PACordonnier/Knocklet/docs/plugin/fr_FR/partie_3.asciidoc

===== PHP
Ce dossier contient la vue à proprement parler, dedans on retrouve obligatoire la page de configuration du plugin (celle qui apparaîtra quand l'utilisateur fera plugin => catégorie => votre plugin), il est conseillé de nommer celle-ci avec l'id de votre plugin. Il peut aussi contenir le panel (page que l'utilisateur trouvera dans accueil -> nom de votre plugin).

Tous les fichiers dans ce dossier doivent finir par .php et doit obligatoirement commencer par :

----
<?php
if (!isConnect('admin')) {
    throw new Exception('{{401 - Accès non autorisé}}');
 }
 sendVarToJS('eqType', 'mail');
 ?>
----
Une fois sur cette page vous aurez accès en php à toutes les fonctions du core de jeedom (voir http://dev.jeedom.fr) ainsi qu'à celles de tous les modules installés donc le vôtre aussi.

Toutes ces pages étant des vues elles utilisent principalement la syntaxe HTML. Pour tout ce qui est présentation, Jeedom se base principalement sur  bootstrap donc toute la documentation est applicable (http://getbootstrap.com/).

Pour simplifier la création de plugin vous pouvez inclure dans votre page le script javascript de template pour les plugins :

----
<?php include_file('core', 'plugin.template', 'js'); ?>
----
A mettre tout en bas de votre page et utile uniquement sur la page de configuration de votre plugin. Ce script permet de réduire le javascript obligatoire à une seule fonction (voir partie sur les fichiers JS).

Dans votre page de configuration une syntaxe html a été mise en place pour vous simplifier la vie. Donc pour la plupart des plugins vous n'aurez  à faire que du html pour stocker vos informations en base de données et donc vous en resservir du coté de votre classe.

Pour la syntaxe c'est assez simple votre élément (input, select...) doit avoir la classe css eqLogicAttr (ou cmdAttr pour les commandes) et un attribut indiquant le nom de la propriété :

----
<input type="text" class="eqLogicAttr form-control" data-l1key="name" placeholder="{{Nom de l'équipement mail}}"/>
----
Là par exemple lors du chargement des données jeedom mettra la valeur du nom de l'équipement dans l'input et lors de la sauvegarde récupérera celle-ci pour la remettre en BDD. Petite astuce certaines propriétés sont en fait des chaînes JSON en BDD (ça permet d'avoir vraiment pas mal de libertés pour le plugin), dans ce cas il suffit de faire :

----
<input class="eqLogicAttr form-control" data-l1key='configuration' data-l2key='fromName' />
----
Pour la liste des propriétés des équipements c'est ici et des commandes c'est ici (pour voir les propriétés qui sont de JSON il suffit de regarder le getter ou le setter si celui-ci prend 2 paramètres alors c'est du JSON)

Dernier point important sur la page de configuration celle-ci peut contenir autant d'équipements et de commandes que nécessaire. Cependant il y a quelques règles à respecter :

Tous les éléments ayant la classe eqLogicAttr doivent être dans un élément ayant la classe css eqLogic
Idem pour les éléments de classe css cmdAttr qui doivent être dans un élément de classe cmd.
Toutes les commandes d'un équipement doivent se trouver dans l'élément ayant la classe eqLogic correspondant

===== JS

Tous les fichiers JS doivent se trouver dans le dossier JS (facile !!!). Il est conseillé de le nommer du même ID que votre plugin (pour la partie configuration, pour le panel vous faîtes comme vous voulez). Ce fichier JS (celui de la configuration du plugin) doit au minimum contenir une méthode addCmdToTable qui prend en paramètre l'objet commande à ajouter. Voici un exemple simple :

----
function addCmdToTable(_cmd) {
    if (!isset(_cmd)) {
        var _cmd = {configuration: {}};
     }
 	var tr = '';     tr += '';
     tr += '<input class="cmdAttr form-control input-sm" data-l1key="id" style="display : none;">';
 	tr += '<input class="cmdAttr form-control input-sm" data-l1key="name">';     tr += '<input class="cmdAttr form-control input-sm" data-l1key="configuration" data-l2key="recipient">';     tr += '';
     tr += '<input class="cmdAttr form-control input-sm" data-l1key="type" value="action" style="display : none;">';
     tr += '<input class="cmdAttr form-control input-sm" data-l1key="subType" value="message" style="display : none;">';
     if (is_numeric(_cmd.id)) {
        tr += '<a class="btn btn-default btn-xs cmdAction" data-action="test"><i class="fa fa-rss"></i> {{Tester}}</a>';
     }
     tr += '<i class="fa fa-minus-circle pull-right cmdAction cursor" data-action="remove"></i></td>';
 	tr += '';
     $('#table_cmd tbody').append(tr);
    $('#table_cmd tbody tr:last').setValues(_cmd, '.cmdAttr');
}
----

Vous remarquerez qu'il y a une ligne par commande et que celle-ci a bien la classe css cmd. Vous pouvez aussi voir les éléments qui ont la classe cmdAttr.

Plusieurs points importants :

- cette fonction peut être appelée avec un objet vide (d'où les 3 premières lignes) lors de l'ajout d'une nouvelle commande
- la dernière ligne permet d'initialiser tous les champs une fois la ligne insérée

Dernier point un exemple plus complet avec type et sous-type de commande :

----
function addCmdToTable(_cmd) {
    if (!isset(_cmd)) {
        var _cmd = {};
    }
     if (!isset(_cmd.configuration)) {
        _cmd.configuration = {};
    }
     var selRequestType = '<select style="width : 90px;" class="cmdAttr form-control input-sm" data-l1key="configuration" data-l2key="requestType">';
     selRequestType += '<option value="script">{{Script}}</option>';
     selRequestType += '<option value="http">{{Http}}</option>';
     selRequestType += '</select>';
 	var tr = '';     tr += '<input class="cmdAttr form-control input-sm" data-l1key="name" style="width : 140px;">';     
 	tr += '<input class="cmdAttr form-control input-sm" data-l1key="id"  style="display : none;">';     
 	tr += '' + selRequestType;
    tr += '<div class="requestTypeConfig" data-type="http">';
     tr += '<input type="checkbox" class="cmdAttr" data-l1key="configuration" data-l2key="noSslCheck" />Ne pas vérifier SSL';
    tr += '</div>';  
 	tr += '';     tr += '';
     tr += '<span class="type" type="' + init(_cmd.type) + '">' + jeedom.cmd.availableType() + '</span>';
     tr += '<span class="subType" subType="' + init(_cmd.subType) + '"></span>';   
 	tr += '';     tr += '<textarea style="height : 95px;" class="cmdAttr form-control input-sm" data-l1key="configuration" data-l2key="request"></textarea>';
     tr += '<a class="btn btn-default browseScriptFile cursor input-sm" style="margin-top : 5px;"><i class="fa fa-folder-open"></i> {{Parcourir}}</a> ';
     tr += '<a class="btn btn-default editScriptFile cursor input-sm" style="margin-top : 5px;"><i class="fa fa-edit"></i> {{Editer}}</a> ';
     tr += '<a class="btn btn-success newScriptFile cursor input-sm" style="margin-top : 5px;"><i class="fa fa-file-o"></i> {{Nouveau}}</a> ';
     tr += '<a class="btn btn-danger removeScriptFile cursor input-sm" style="margin-top : 5px;"><i class="fa fa-trash-o"></i> {{Supprimer}}</a> ';
     tr += '<a class="btn btn-warning bt_shareOnMarket cursor input-sm" style="margin-top : 5px;"><i class="fa fa-cloud-upload"></i> {{Partager}}</a> ';
     tr += '</div>';   
 	tr += '';     tr += '';
     tr += '<input class="cmdAttr form-control tooltips input-sm" data-l1key="unite"  style="width : 100px;" placeholder="{{Unité}}" title="{{Unité}}">';
     tr += '<input class="tooltips cmdAttr form-control input-sm" data-l1key="configuration" data-l2key="minValue" placeholder="{{Min}}" title="{{Min}}"> ';
     tr += '<input class="tooltips cmdAttr form-control input-sm" data-l1key="configuration" data-l2key="maxValue" placeholder="{{Max}}" title="{{Max}}">';   
 	tr += '';     tr += '';
     tr += '<span><input type="checkbox" class="cmdAttr" data-l1key="isHistorized" /> {{Historiser}}<br/></span>';
 	tr += '';     tr += '';
     if (is_numeric(_cmd.id)) {
        tr += '<a class="btn btn-default btn-xs cmdAction" data-action="test"><i class="fa fa-rss"></i> {{Tester}}</a>';
     }
     tr += '<i class="fa fa-minus-circle pull-right cmdAction cursor" data-action="remove"></i></td>';
 	tr += '';
     $('#table_cmd tbody').append(tr);
    $('#table_cmd tbody tr:last').setValues(_cmd, '.cmdAttr');
	
    if (isset(_cmd.configuration.requestType)) {
        $('#table_cmd tbody tr:last .cmdAttr[data-l1key=configuration][data-l2key=requestType]').value(init(_cmd.configuration.requestType));
        $('#table_cmd tbody tr:last .cmdAttr[data-l1key=configuration][data-l2key=requestType]').trigger('change');
    }
 	
     if (isset(_cmd.type)) {
        $('#table_cmd tbody tr:last .cmdAttr[data-l1key=type]').value(init(_cmd.type));
    }
     jeedom.cmd.changeType($('#table_cmd tbody tr:last'), init(_cmd.subType));
    initTooltips();
}
----

Ici on peut remarquer :

- jeedom.cmd.availableType() qui va insérer un select avec la liste des types connus (action et info pour le moment)
- <span class="subType" subType="' + init(_cmd.subType) + '"></span>: l'endroit où le select de sous type doit être posé
- jeedom.cmd.changeType($('#table_cmd tbody tr:last'), init(_cmd.subType)) qui permet d'initialiser le sous type avec la bonne valeur

D'autres fonctions javascript peuvent être utilisées :

- printEqLogic qui prend en paramètre tout l'objet de l'équipement (utile en cas de traitement de données avant de les restituer). Elle est appelée lors de l'affichage des données de l'équipement
- saveEqLogic qui prend en paramètre l'objet équipement qui va être sauvegardé en base de données (utile si vous devez faire du traitement avant sauvegarde)
Dernière chose, pour les fichiers JS, voici comment les inclure de manière propre sur votre page php :

----
<?php include_file('desktop', 'weather', 'js', 'weather'); ?>
----
Le premier argument donne le dossier dans lequel le trouver (attention c'est le dossier père du dossier JS), le deuxième le nom de votre javascript, le troisième indique à Jeedom que c'est un fichier JS et le dernier dans quel plugin il se trouve.

===== CSS
Ce dossier contient vos fichiers CSS (il ne devrait pas être trop utilisé) , voici comment les inclure sur votre page :

----
<?php include_file('desktop', 'weather', 'css', 'weather'); ?>
----
Le premier argument donne le dossier dans lequel le trouver (attention c'est le dossier père du dossier CSS), le deuxième le nom de votre fichier css, le troisième indique à Jeedom que c'est un fichier CSS et le dernier dans quel plugin il se trouve.

===== MODAL
Le dossier modal vous permet de stocker vos fichiers php destinés à afficher des modals. Voici comment les appeler à partir de votre page principale (ce code se met dans un fichier javascript) :

On peut voir :

----
$('#md_modal').dialog({title: "{{Classe du périphérique}}"});
 $('#md_modal').load('index.php?v=d&plugin=zwave&modal=show.class&id=' + $('.eqLogicAttr[data-l1key=id]').value()).dialog('open');
----

La première permet de mettre un titre à votre modal

La deuxième ligne charge votre modal et l'affichage. Pour la syntaxe c'est assez simple : plugin l'id de votre plugin, modal le nom de votre modal sans le php et ensuite les paramètres que vous voulez lui passer

===== API JS
Ce n'est pas un dossier mais dans les dernières versions de Jeedom celui-ci offre au développeur toute une api javascript (ça évite d'écrire des appels ajax dans tous les sens). J'essayerai de faire un article pour expliquer les différentes fonctionnalités mais vous pouvez déjà trouver le code ici.

Voilà pour les détails du dossier desktop. Je me doute que c'est pas des plus complets (j'essayerai de le compléter en fonction des différentes demandes que je reçois) mais j’espère que grâce à ça vous pourrez commencer à faire des plugins pour Jeedom.

===== Trucs et astuces

.Assitant cron

----
$('body').delegate('.helpSelectCron','click',function(){
  var el = $(this).closest('.schedule').find('.scenarioAttr[data-l1key=schedule]');
  jeedom.getCronSelectModal({},function (result) {
    el.value(result.value);
  });
});
----

Quand on clique sur le bouton d'assistant, ça récupère l'input dans lequel écrire puis appelle l'assistant. Une fois la configuration finie dans l’assistant, le résultat est récuperé puis écrit dans l'input précédemment selectionné
