PACordonnier/Knocklet/pitch/Knocklet.pptx

## Knocklet

Pitch du 23 Septembre 2016
PFE1619 Dome – Valorisation Partenariat

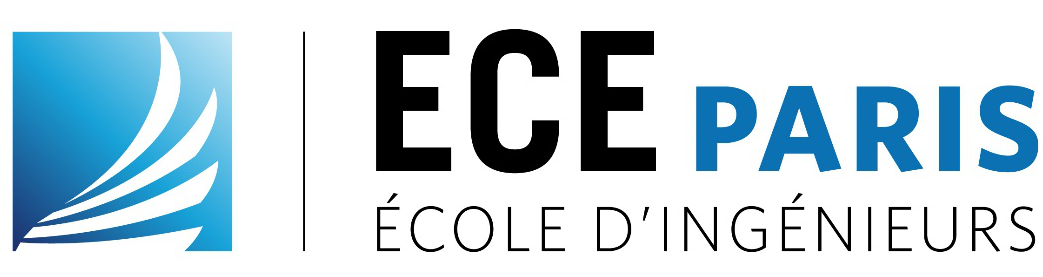
[picture p1: figure]
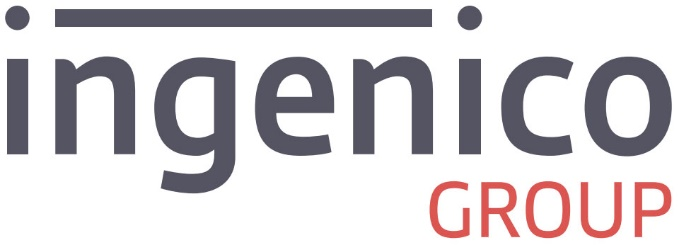
[picture p2: figure]

## La domotique, une simplification de la vie à la maison

Knocklet, la simplification de la domotique

## Etat de l’art

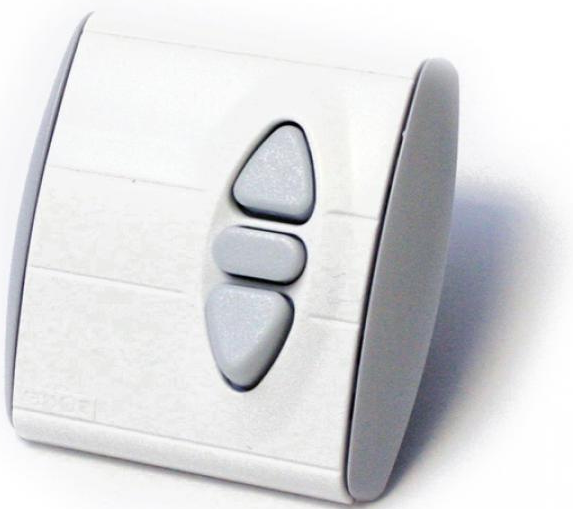
[picture p3: figure]
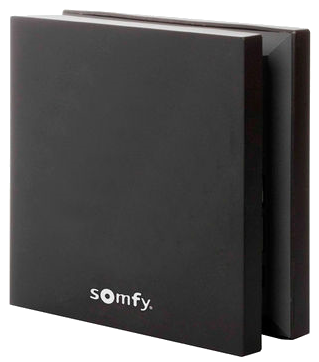
[picture p4: figure]
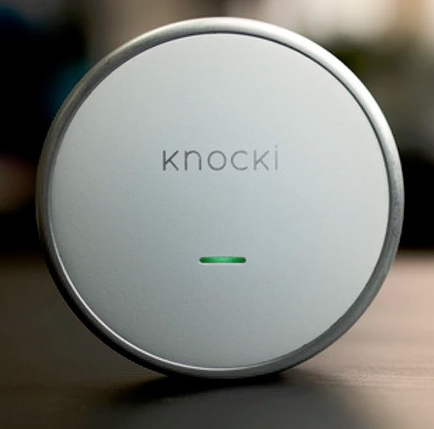
[picture p5: figure]
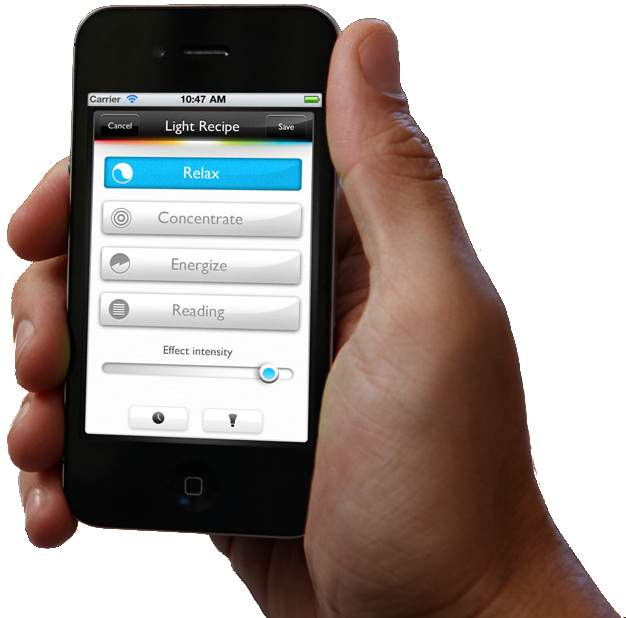
[picture p6: figure]

## Notre solution

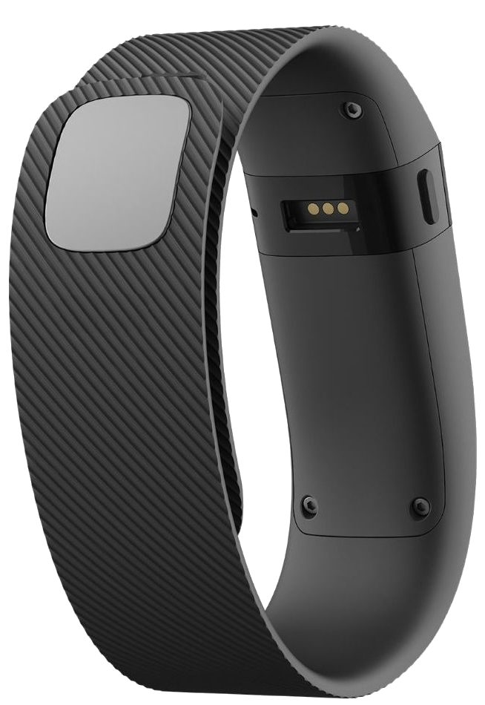
[picture p7: figure]

## Décomposition du projet

Détection d’un « knock »

Liaison avec la centrale domotique

Localisation « indoor »

## Notre partenaire

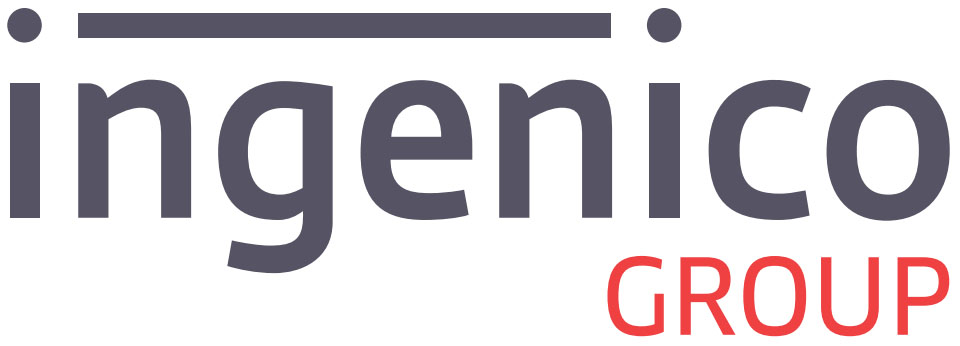
[picture p8: figure]

## Valorisation partenariat

Etude sur les technologies sans fil
Prototypage
Expertise en électronique et sécurité
Matériel

## Merci de votre attention
