PACordonnier/Knocklet/docs/capture_numero_pack_jeedom.PNG

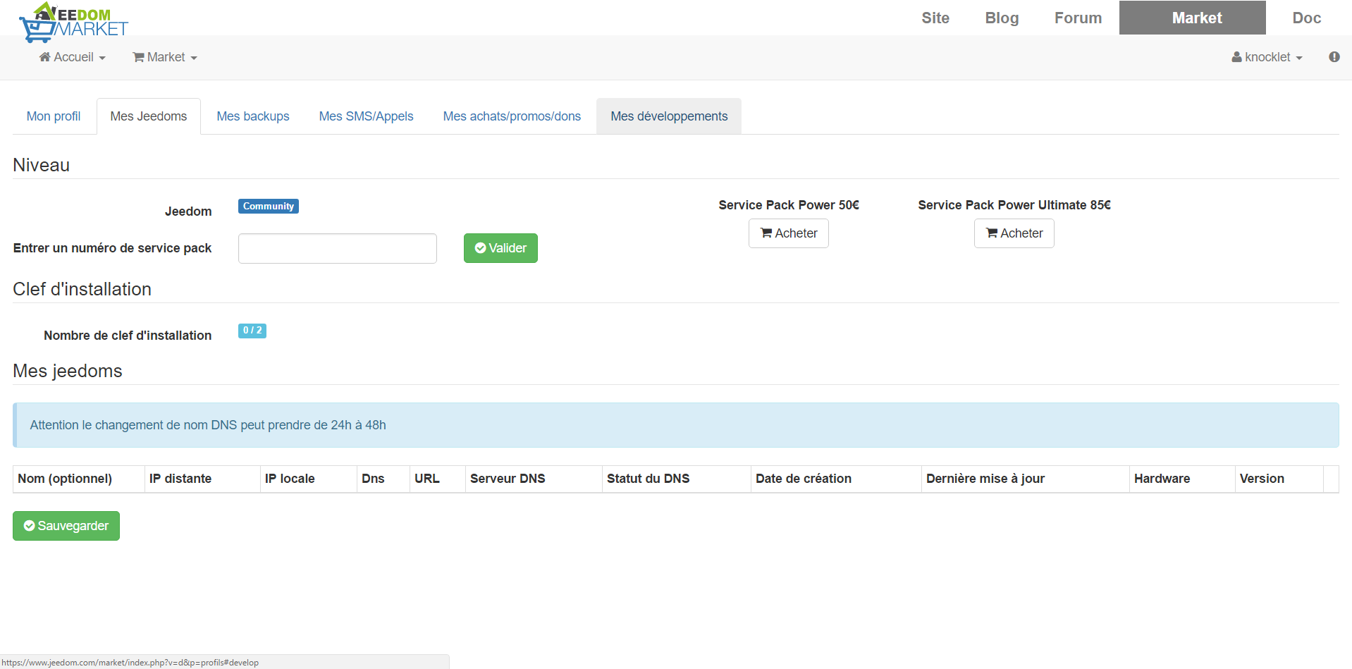
docs/capture_numero_pack_jeedom.PNG
