PACordonnier/Knocklet/docs/interface.png

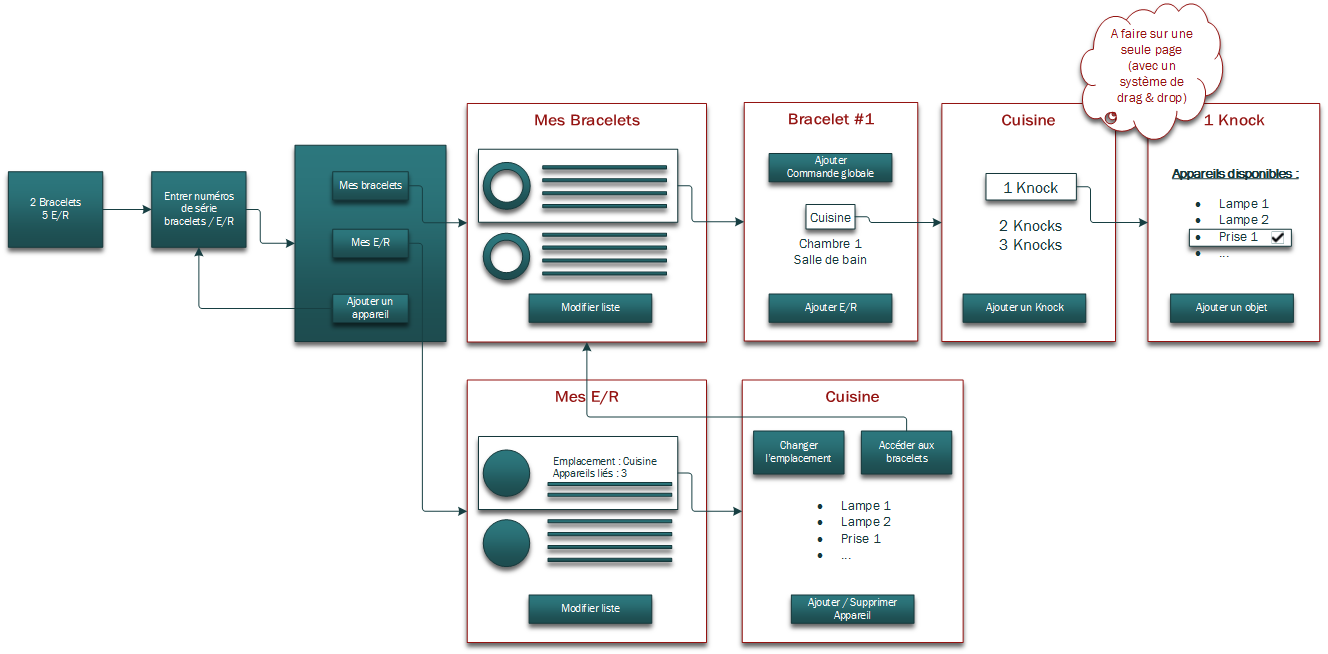
docs/interface.png
