PACordonnier/Knocklet/docs/CDC_KNOCKLET.pdf

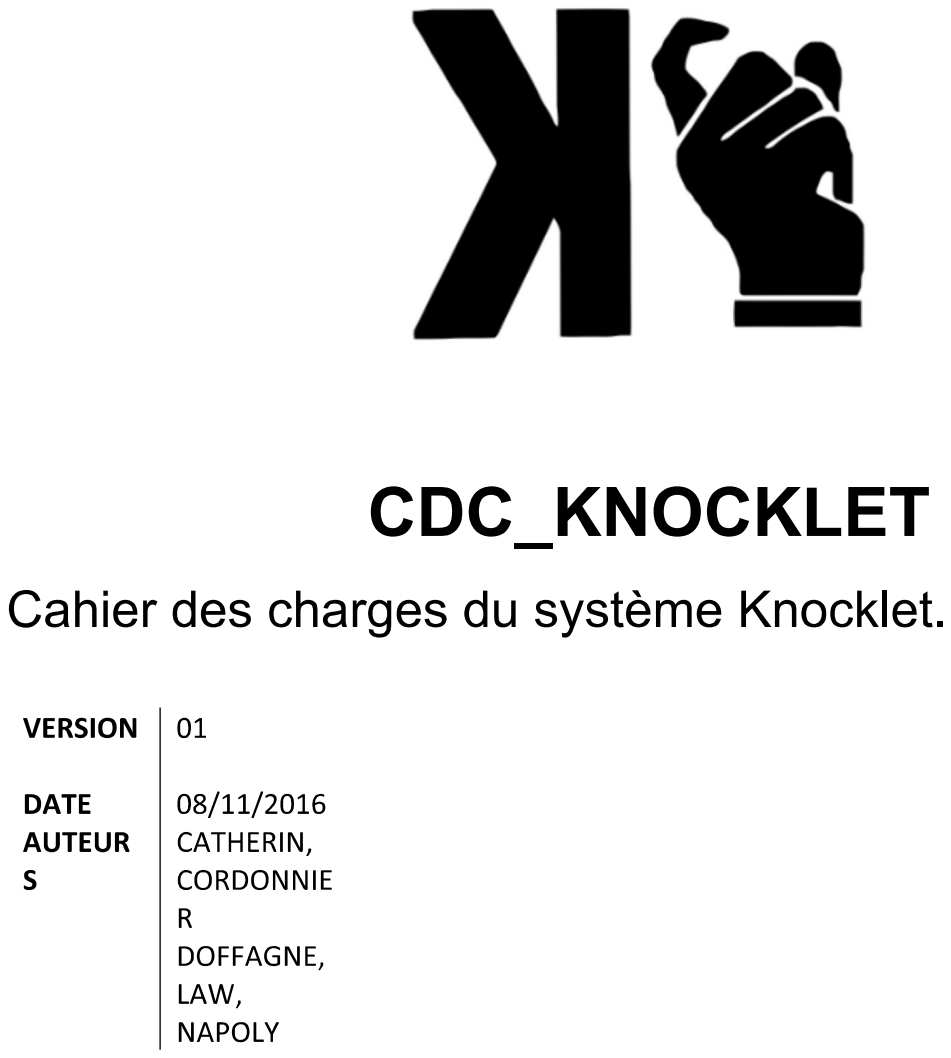
[picture p40: page 1]

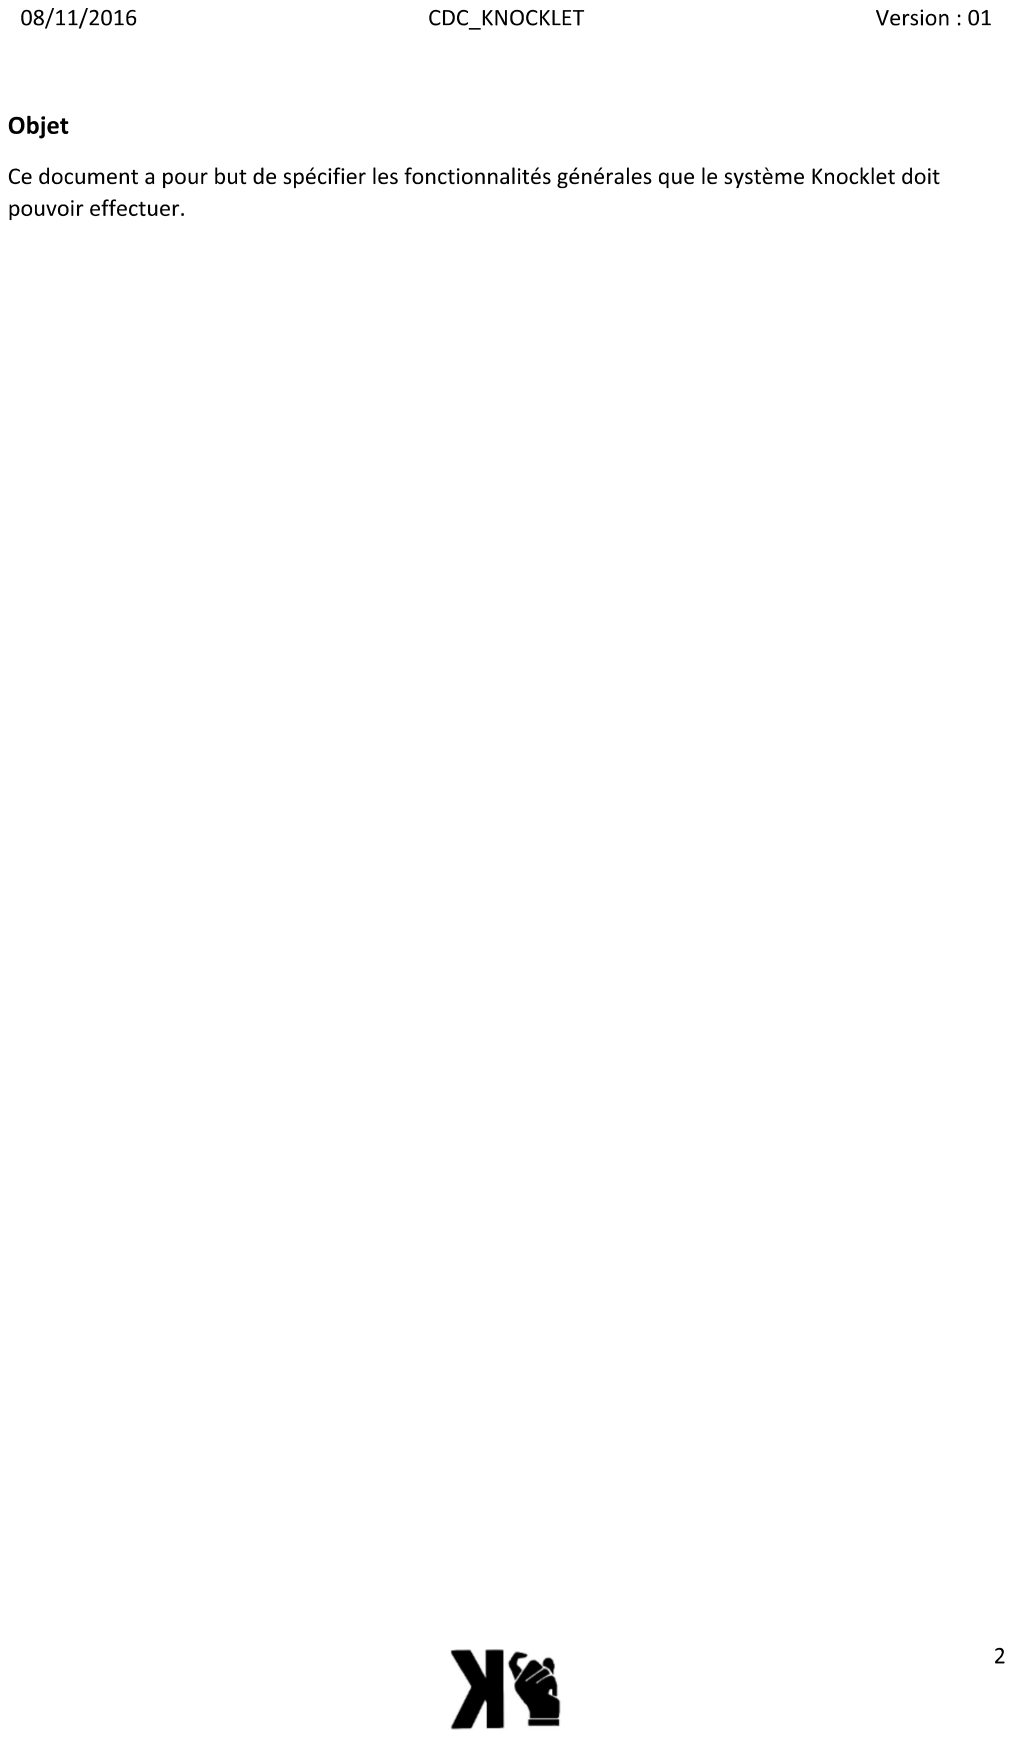
[picture p41: page 2]

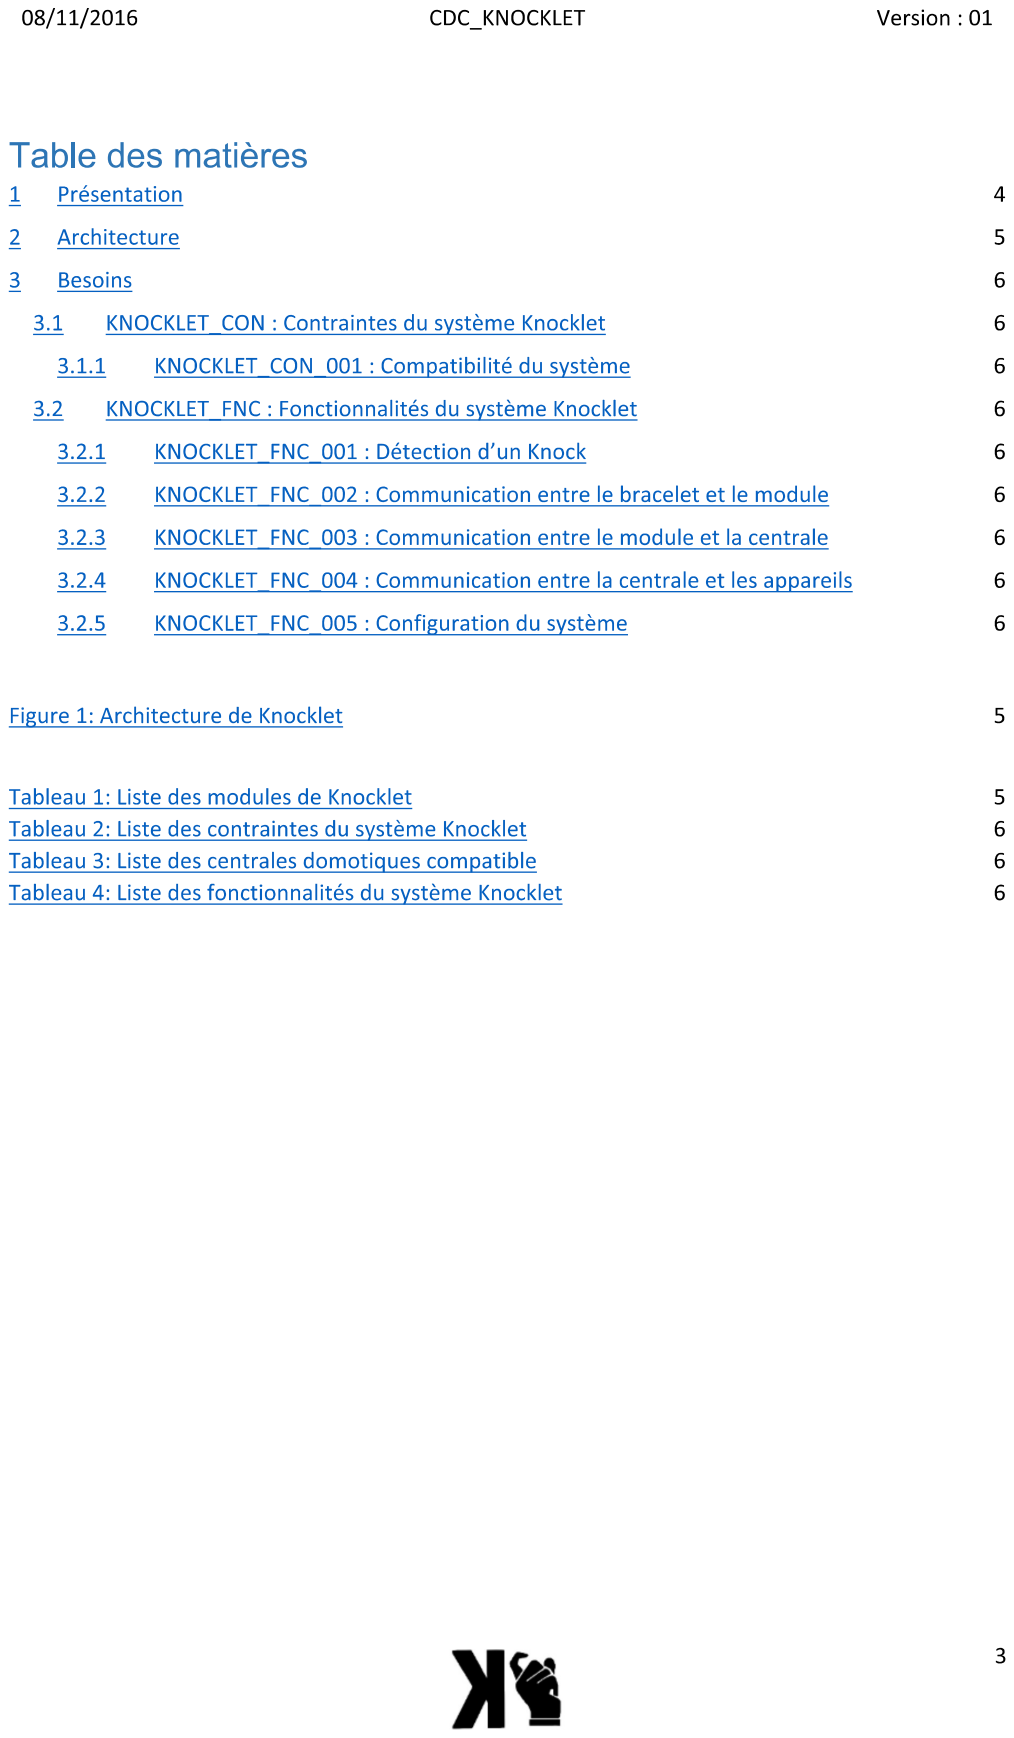
[picture p42: page 3]

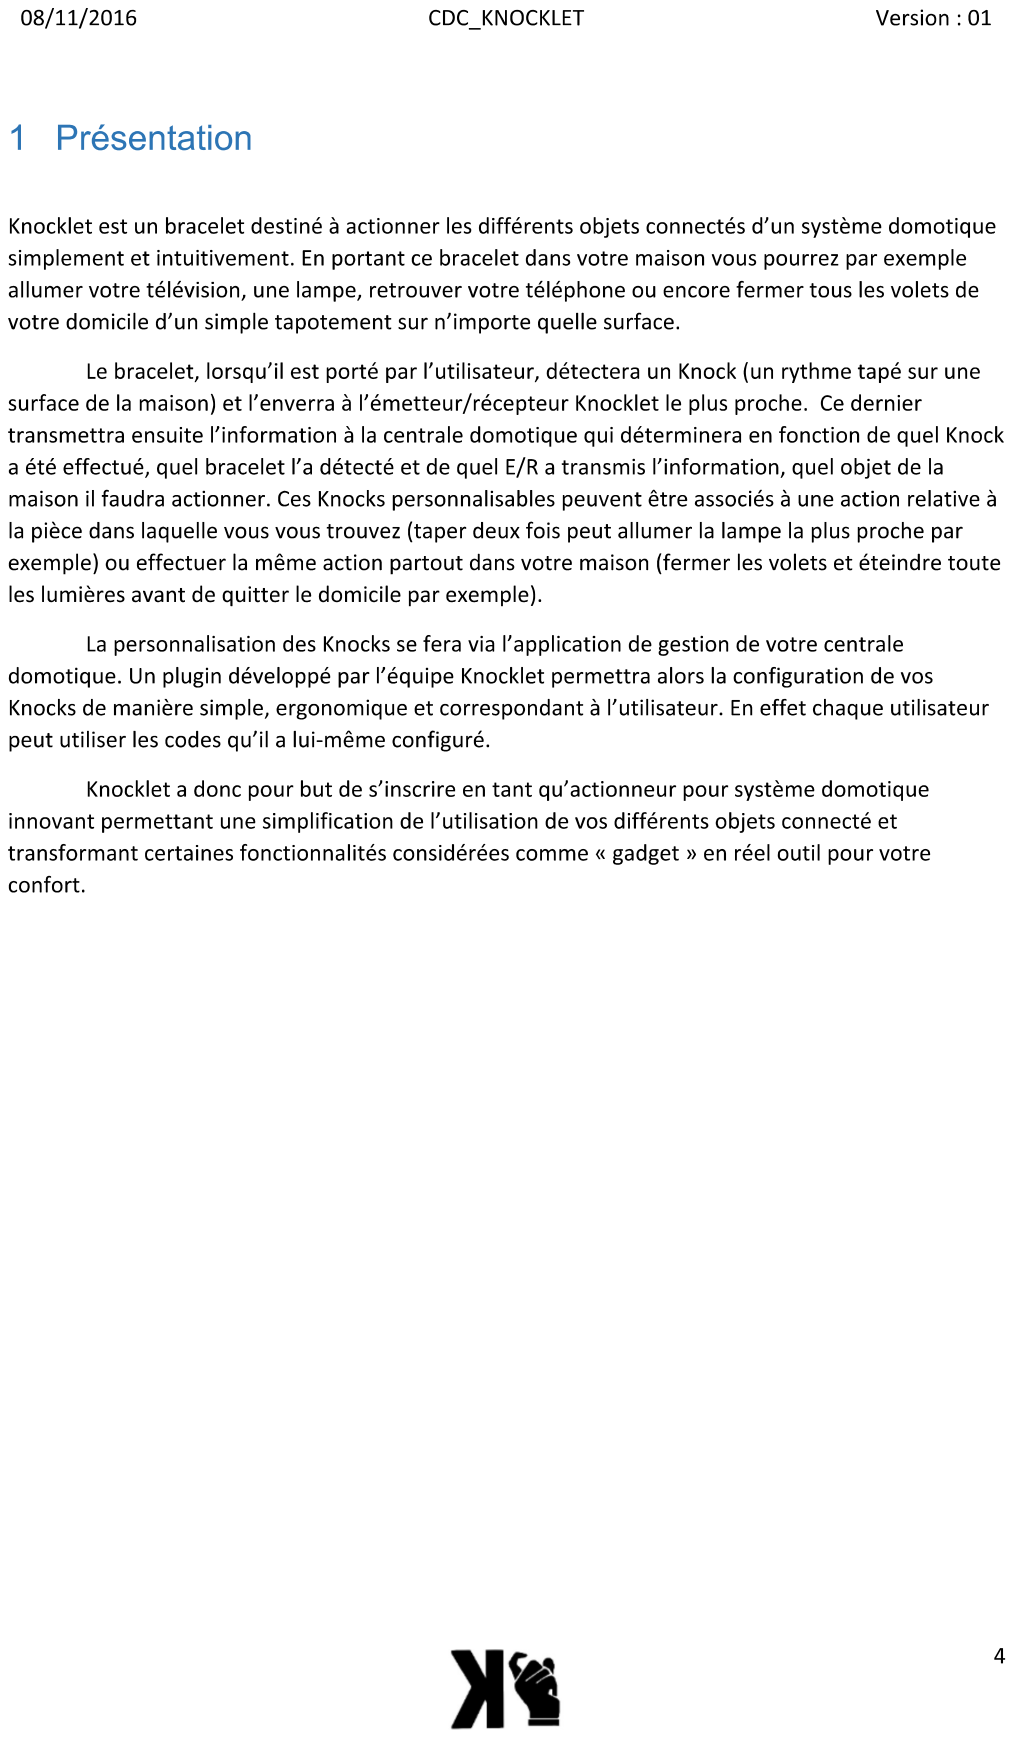
[picture p43: page 4]

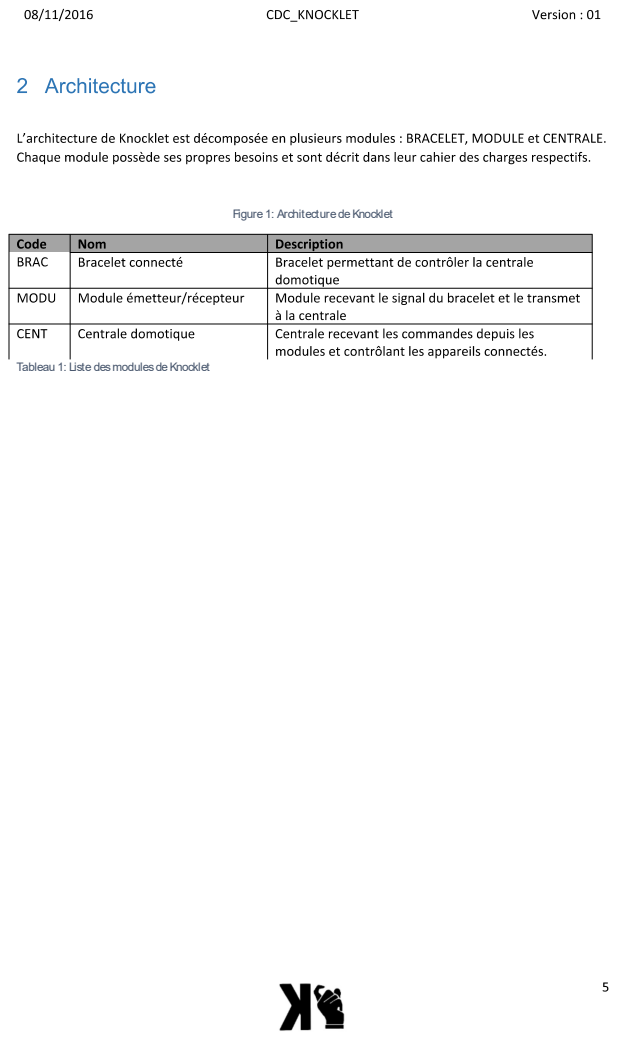
[picture p44: page 5]

Figure 1: Architecture de Knocklet

Tableau 1: Liste des modules de Knocklet

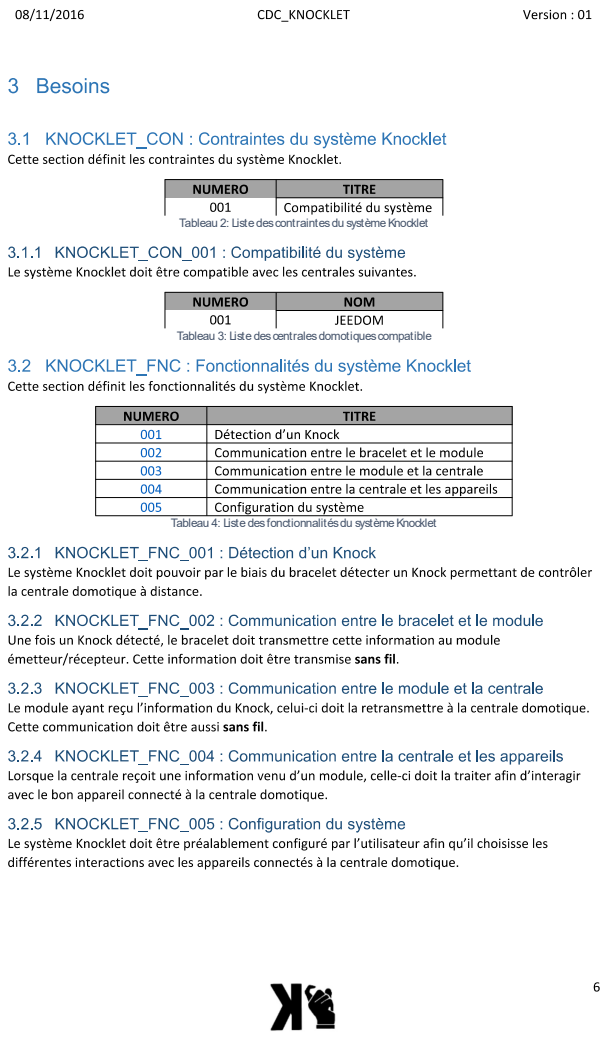
[picture p45: page 6]

Tableau 2: Liste des contraintes du système Knocklet

Tableau 3: Liste des centrales domotiques compatible

Tableau 4: Liste des fonctionnalités du système Knocklet
