PACordonnier/Knocklet/(list of files, drawings)

Other design files:
PCB/KNOCKLET_BRAC/Accelerometres/Accelerometres.PcbLib
PCB/KNOCKLET_BRAC/Accelerometres/Accelerometres.SchLib
PCB/KNOCKLET_BRAC/Accelerometres/Capacitor_10uf_0805/Capacitor_10uf_0805.PcbLib
PCB/KNOCKLET_BRAC/Accelerometres/Capacitor_10uf_0805/Capacitor_10uf_0805.SchLib
PCB/KNOCKLET_BRAC/Accelerometres/Capacitor_10uf_0805/PADS Libraries.PrjPcb
PCB/KNOCKLET_BRAC/Accelerometres/Capacitor_100nf_0805/Capacitor_100nf_0805.PcbLib
PCB/KNOCKLET_BRAC/Accelerometres/Capacitor_100nf_0805/Capacitor_100nf_0805.SchLib
PCB/KNOCKLET_BRAC/Accelerometres/Capacitor_100nf_0805/PADS Libraries.PrjPcb
PCB/KNOCKLET_BRAC/Accelerometres/LIS2DE12TR/LIS2DE12TR.PcbDoc
PCB/KNOCKLET_BRAC/Accelerometres/LIS2DE12TR/LIS2DE12TR.PrjPcb
PCB/KNOCKLET_BRAC/Accelerometres/LIS2DE12TR/LIS2DE12TR.SchDoc
PCB/KNOCKLET_BRAC/Accelerometres/MMA8452QT/MMA8452QT.PcbDoc
PCB/KNOCKLET_BRAC/Accelerometres/MMA8452QT/MMA8452QT.PrjPcb
PCB/KNOCKLET_BRAC/Accelerometres/MMA8452QT/MMA8452QT.SchDoc
PCB/KNOCKLET_BRAC/Accelerometres/MMA8652FCR1/MMA8652FCR1.PcbDoc
PCB/KNOCKLET_BRAC/Accelerometres/MMA8652FCR1/MMA8652FCR1.PrjPcb
PCB/KNOCKLET_BRAC/Accelerometres/MMA8652FCR1/MMA8652FCR1.SchDoc
PCB/KNOCKLET_BRAC/Accelerometres/PCB_accelerometres.PrjPcb
PCB/KNOCKLET_BRAC/Bracelet.PcbDoc
PCB/KNOCKLET_BRAC/Copy of MB1136.SchDoc
PCB/KNOCKLET_BRAC/Copy of MCU_64.SchDoc
PCB/KNOCKLET_BRAC/Extension Knocklet.SchDoc
PCB/KNOCKLET_BRAC/Gen_Connectors/Gen_Connectors.SchLib
PCB/KNOCKLET_BRAC/Gen_Devices/Gen_Devices.schlib
PCB/KNOCKLET_BRAC/Gen_Devices/Project Outputs for Gen_Devices/Gen_Devices/Gen_Devices.pcblib
PCB/KNOCKLET_BRAC/Gen_Devices/Project Outputs for Gen_Devices/Gen_Devices/Gen_Devices.schlib
PCB/KNOCKLET_BRAC/KNOCKLET_BRAC.PcbDoc
PCB/KNOCKLET_BRAC/KNOCKLET_BRAC.PcbLib
PCB/KNOCKLET_BRAC/KNOCKLET_BRAC.PrjPcb
PCB/KNOCKLET_BRAC/KNOCKLET_BRAC.SchLib
PCB/KNOCKLET_BRAC/logo.PcbDoc
PCB/KNOCKLET_BRAC/MB1136.SCHLIB
PCB/KNOCKLET_BRAC/Shield Accelerometre/Shield_MMA8452_bleu/Shield_MMA8452_bleu.PcbDoc
PCB/KNOCKLET_BRAC/Shield Accelerometre/Shield_MMA8452_bleu/Shield_MMA8452_bleu.PrjPcb
PCB/KNOCKLET_BRAC/Shield Accelerometre/Shield_MMA8452_bleu/Shield_MMA8452_bleu.SchDoc
PCB/KNOCKLET_BRAC/Shield Accelerometre/Shield_MMA8452_rouge/Shield_MMA8452_rouge.PcbDoc
PCB/KNOCKLET_BRAC/Shield Accelerometre/Shield_MMA8452_rouge/Shield_MMA8452_rouge.PrjPcb
PCB/KNOCKLET_BRAC/Shield Accelerometre/Shield_MMA8452_rouge/Shield_MMA8452_rouge.SchDoc
PCB/KNOCKLET_BRAC/Shield Accelerometre/Shield_MMA8452_rouge/Shield_MMA8452_rouge/Shield_MMA8452_rouge.PrjPcb
