PACordonnier/Knocklet/KNOCKLET_BRAC/Knocklet/ACcelero.cpp

/******************************************************************************
* @file	   ACcelero.cpp
* @author  Nicolas LAW
* @version V1.0.0
* @date    11-January-2017
* @brief   Gestionnaire de l'accéleromètre
*******************************************************************************/

#include "MMA8452.h"	// Librairie de l'accéleromètre
#include "ACcelero.h"	// Gestionnaire de l'accéleromètre
#include "BParadef.h"	// Définition des paramètres relatifs au BLE
#include "main.h"		// Include du CORE

/*----------------------------------------------------------------------------
* ALLOCATION DE VARIABLES
*---------------------------------------------------------------------------*/
MMA8452			ACX_acce(PB_9, PB_8, 100000);	// Connection de l'accéleromètre (I2C: sda, scl, frequency)
InterruptIn		ACX_taps(PC_2);					// Interrupt détectant un tap
InterruptIn		ACX_butt(PC_13);				// Interrupt du mode configuration
Timer			ACX_time;						// Timer lorsqu'un tap est détecté
uint8_t			ACX_ntap;						// Nombres de tap
bool			ACX_stop;						// Désactivation de l'interrupt pendant l'échange Bluetooth

/*----------------------------------------------------------------------------
* ACX_buttfonc() : Fonction lorsque le boutton de configuration est activé
*-----------------------------------------------------------------------------
* Input  : - 
* Output : -
* Return : - Success or not
*-----------------------------------------------------------------------------
*
*---------------------------------------------------------------------------*/
void ACX_buttfonc(void) 
{ 
	// Désactivation des interrupt
	ACX_taps.disable_irq();
	ACX_butt.disable_irq();
	
	// Arrêt et reset du timer
	ACX_time.stop();
	ACX_time.reset();
	
#if BRAC_ACTI_XBLE
	// Récupération du nombre de tap pour les données Bluetooth
	para.BPX_data.carA.data.vale[0] = -1;
	// Activation du flag pour mise à jour Bluetooth
	para.BPX_data.carA.data.updt = true;
	
	// Log
	Printf("ACX_buttfonc: Broadcast Configuration");
#endif // BRAC_ACTI_XBLE
	
}  

/*----------------------------------------------------------------------------
* ACX_intefonc() : Fonction lorsque une interruption est détecté
*-----------------------------------------------------------------------------
* Input  : - 
* Output : -
* Return : - Success or not
*-----------------------------------------------------------------------------
*
*---------------------------------------------------------------------------*/
void ACX_intefonc(void) 
{ 
	Printf("ACX_intefonc: Tap detecte");
	// Si le timer est inactif
	if (ACX_time.read_ms() == 0) 
	{ 
		// Démarrage du timer
		ACX_time.start(); 
	}
	// Timer déjà en marche, reset du temps timer
	else 
	{ 
		ACX_time.reset(); 
	} 
	
	// Incrémentation du nombre de tap
	ACX_ntap++; 
}  

/*----------------------------------------------------------------------------
* ACX_acceinit() : Initialisation des paramètres de l'accéleromètre
*-----------------------------------------------------------------------------
* Input  : - 
* Output : -
* Return : - Success or not
*-----------------------------------------------------------------------------
*
*---------------------------------------------------------------------------*/
bool ACX_acceinit(void)
{
	// Initialisation de la variable d'arrêt de l'interrupt
	ACX_stop = false;
	
	// Initialisation de l'interrupt Button
	ACX_butt.rise(&ACX_buttfonc);
	
	// Initialisation de l'interrupt sur le Core
	ACX_taps.rise(&ACX_intefonc);
	
	return true;
}

/*----------------------------------------------------------------------------
* ACX_acceconf() : Configuration de l'accéleromètre
*-----------------------------------------------------------------------------
* Input  : - 
* Output : -
* Return : - Success or not
*-----------------------------------------------------------------------------
*
*---------------------------------------------------------------------------*/
bool ACX_acceconf(void)
{
	// Standby mode TEST
	// pc.printf("Value registre standby: %d\n",acc.standby());
	
	// Standby Mode
	if (ACX_acce.standby() != ACX_ACCE_GOOD)
	{
		return false;
	}

	// Enable LPF
	//acc.writeRegister(0x0F, 0x10);
	//
	// ODR : 400 Hz, Standby Mode
	if (ACX_acce.writeRegister(MMA8452_CTRL_REG_1, 0x08) != ACX_ACCE_GOOD)
	{
		return false;
	}
	// Pulse Configuration : Single tap
	if (ACX_acce.writeRegister(MMA8452_PULSE_CFG, 0x15) != ACX_ACCE_GOOD)
	{
		return false;
	}
	// Pulse threshold for X,Y,Z
	// Threshold X: 2g
	if (ACX_acce.writeRegister(MMA8452_PULSE_THSX, 0x15) != ACX_ACCE_GOOD)
	{
		return false;
	}
	// Threshold Y: 2g
	if (ACX_acce.writeRegister(MMA8452_PULSE_THSY, 0x15) != ACX_ACCE_GOOD)
	{
		return false;
	}
	// Threshold Z: 2g
	if (ACX_acce.writeRegister(MMA8452_PULSE_THSZ, 0x15) != ACX_ACCE_GOOD)
	{
		return false;
	}
	// Pulse Time Window 1: 20 ms, Normal Mode, No LPF
	if (ACX_acce.writeRegister(MMA8452_PULSE_TMLT, 0x20) != ACX_ACCE_GOOD)
	{
		return false;
	}
	// Pulse Latency Timer: 250 ms 
	if (ACX_acce.writeRegister(MMA8452_PULSE_LTCY, 0x64) != ACX_ACCE_GOOD)
	{
		return false;
	}
	// Interrupt Routing
	// Enable Interrupt Register
	if (ACX_acce.writeRegister(MMA8452_CTRL_REG_4, 0x08) != ACX_ACCE_GOOD)
	{
		return false;
	}
	// Route INT1 to System Interrupt
	if (ACX_acce.writeRegister(MMA8452_CTRL_REG_5, 0x08) != ACX_ACCE_GOOD)
	{
		return false;
	}
	// Active Mode
	if (ACX_acce.writeRegister(MMA8452_CTRL_REG_1, 0x01) != ACX_ACCE_GOOD)
	{
		return false;
	}
	
	// Configuration OK
	return true;
}

/*----------------------------------------------------------------------------
* ACX__process() : Process de l'accéleromètre
*-----------------------------------------------------------------------------
* Input  : - 
* Output : -
* Return : - Success or not
*-----------------------------------------------------------------------------
*
*---------------------------------------------------------------------------*/
bool ACX__process(void)
{
	// Vérification de réactivation de l'interrupt
	if (ACX_stop == true)
	{
		// Réactivation de l'interrupt
		ACX_taps.enable_irq();
		ACX_butt.enable_irq();
		
		// Remise à zéro du flag
		ACX_stop = false;
	}
	
	// Durée sans tap dépasse le délai maximum
	if (ACX_time.read_ms() > ACX_ACCE_TOUT) 
	{   	
		// Arrêt et reset du timer
		ACX_time.stop();
		ACX_time.reset();
		
		Printf("ACX__process: Nombre de taps: %d", ACX_ntap);
		
		// Blindage de la valeur
		if (ACX_ntap > ACX_ACCE_NMAX || ACX_ntap == 0 || ACX_ntap == 1)
		{
			// Trop de tap détecté
			Printf("ACX__process: Taps ignore");
		}
		else
		{
			// Tap valide
			Printf("ACX__process: Taps OK");
			// Désactivation des interrupts
			ACX_taps.disable_irq();
			ACX_butt.disable_irq();
#if BRAC_ACTI_XBLE
			// Récupération du nombre de tap pour les données Bluetooth
			para.BPX_data.carA.data.vale[0] = ACX_ntap;
			// Activation du flag pour mise à jour Bluetooth
			para.BPX_data.carA.data.updt = true;
#else 
			// Activation du flag pour réactiver l'interrupt
			ACX_stop = true;
#endif // BRAC_ACTI_XBLE	
		}

		// Remise à zéro du nombre de tap
		ACX_ntap = 0;     
	}
	
	return true;
} 
