PACordonnier/Knocklet/KNOCKLET_BRAC/Knocklet/ACcelero.h

/******************************************************************************
* @file	   ACcelero.h
* @author  Nicolas LAW
* @version V1.0.0
* @date    11-January-2017
* @brief   Gestionnaire de l'accéleromètre
*******************************************************************************/
#ifndef _ACCELERO_H_
#define _ACCELERO_H_

#ifdef __cplusplus
extern "C" {
#endif

//****************************************************************************
// LISTE DES PIECES :
//****************************************************************************
// ACX : Traitements généraux
//****************************************************************************

/*----------------------------------------------------------------------------
* VARIABLES EXTERNALISEES
*---------------------------------------------------------------------------*/
extern bool	ACX_stop;		// Désactivation de l'interrupt pendant l'échange Bluetooth
	
/*----------------------------------------------------------------------------
* CONSTANTES
*---------------------------------------------------------------------------*/
#define ACX_ACCE_GOOD 0		// Valeur retour si fonction MMA8452 OK
#define ACX_ACCE_TOUT 600	// Fenêtre de temps pour effectuer X tap (se renouvelle à chaque tap)
#define ACX_ACCE_NMAX 6		// Nombre de taps maximum

/*----------------------------------------------------------------------------
* ACX : Traitements généraux
*---------------------------------------------------------------------------*/
void ACX_buttfonc(void);	// Fonction lorsque le boutton de configuration est activé
void ACX_intefonc(void);	// Fonction lorsque une interruption est détecté
bool ACX_acceinit(void);	// Initialisation des paramètres de l'accéleromètre
bool ACX_acceconf(void);	// Configuration de l'accéleromètre
bool ACX__process(void);	// Process de l'accéleromètre
#ifdef __cplusplus
}
#endif

#endif /* _ACCELERO_H_ */
