PACordonnier/Knocklet/(commit log)

2017-01-03 Ajout de docs
2017-01-03 Ajout librairie en cours
    Problème de conflit
2017-01-04 Ajout librairies BLE
    WARNING
    Le compilateur ne reconnait pas les librairies écrites en C. Attention à bien préciser le type de fichier
2017-01-05 Ajout fichier override SPI init
2017-01-05 Ajout des structures BLE
2017-01-06 Ajout de graine d'ingénieurs
2017-01-06 modification de la reflexion
2017-01-10 Ajout de notes
2017-01-10 API de base
2017-01-10 Ajout de la méthode knock dans l'api - reçoit comme paramètres les id du bracelet et du module, ainsi que le nombre de knocks
2017-01-11 Creation de la classe pour les fonctions knocklet (configuration, stockage...)
2017-01-11 Ajout de la fenetre configuration des knock dans la vue. (Tableau créé automatiquement, aucune ecriture possible)
2017-01-11 Configuration et récupération des données (triplet + cid)
2017-01-12 Ajout de Logs
    Ajout du Serial
    Blindage du nombre de tap
2017-01-12 Ajout de mode
    Modes possibles:
    - Avec/Sans logs
    - Avec/Sans Accelerometre
    - Avec/Sans Bluetooth
2017-01-12 Ajout de constante avant passage en V2
2017-01-12 Chargement et enregistrement des configs depuis le plugin FONCTIONNELS
2017-01-12 Netoyage et Commentaire sur la classe knocklet
2017-01-13 Interface graphique de configuration des bracelet knocklet et de leur sauvegarde V1.0
2017-01-16 Graine de champion
2017-01-16 Fonction d'ajout de bracelet et module -> OK
2017-01-16 Ajout des notes importantes
2017-01-16 Changement du Advertising_rate + changement interrupt PB_2 to PC_2
2017-01-18 Inclusion des configs dans la base de donnée - La transcription des knocks n'a pas été vérifiée (voir getIdFromTriplet)
2017-01-18 Conversion triplet en commande OK - Ajout de la possibilité d'avoir plus commandes pour un triplet + Séparation des cmd et des scenarios
2017-01-18 Ajout des fonctions pour les scenario (pas encore dispo dans l'interface web)
2017-01-19 Changement de la methode d'appareillage pour les equipement (nouvelle methode "init" + ajout de commentaire et execptions
2017-01-19 Ajout d'indications dans l'API + gestion des scenarios ajoutée et testée
2017-01-19 Correction de l'interface graphique avant demo
2017-01-19 Ajout de la gestion des icones (bracelet / module)
2017-01-20 Ajout des paquets nécessaires à l'install
2017-01-23 Ajout de logs pour les posts reçus par l'api
2017-01-23 Ajout de fonctions pour avoir des listes déroulante dans les config de knocket
2017-01-23 Ajout des images (logo/icones)
2017-01-23 Changement de la fenetre de configuration des knocks, mise des options en liste déroulante.
2017-01-25 Ajout des fonctionnalité pour selectionner TOUS (*) les bracelets ou modules pour une config + Passage de l'api ajax en vrai ajax (avec retours)
2017-01-25 Modification de style sur la page de configuration des knocks et ajout de l'option "tous" pour les bracelet et les modules.
2017-01-26 Ajout fichier Altium
    [Accelerometres.PcbLib, Accelerometres.SchLib, Capacitor_100nf_0805.PcbLib, Capacitor_100nf_0805.SchLib, Capacitor_10uf_0805.PcbLib, Capacitor_10uf_0805.SchLib, Carte_RFID.xls, Copy of MB1136.SchDoc]
2017-01-26 Ajout de la temporisation et correction des scenarios
2017-01-26 Implémentation de la configuration des scénarios
2017-01-26 Correction du style et des titres
2017-01-27 PCB termine
    [Bracelet.PcbDoc, Copy of MCU_64.SchDoc, KNOCKLET_BRAC.PcbLib, KNOCKLET_BRAC.PrjPcb, logo.PcbDoc]
2017-01-27 Changement Calibration + Mode Release
2017-01-27 Modification mineures de l'interface et changement de noms de fichiers
2017-02-01 Ajout de l'abstract FR
2017-02-06 Ajout des abstracts
2017-02-07 Suppression de la licence
2017-02-07 Ajout de commentaires sur les codes go
